Keybored02/simple_stepper_motor_analyzer_5A/3d/README.md

This model is designed to be output on an SLA printer.
The top and bottom of the case are just plugged into each other.
