Keybored02/simple_stepper_motor_analyzer_5A/3d/case_top.stl

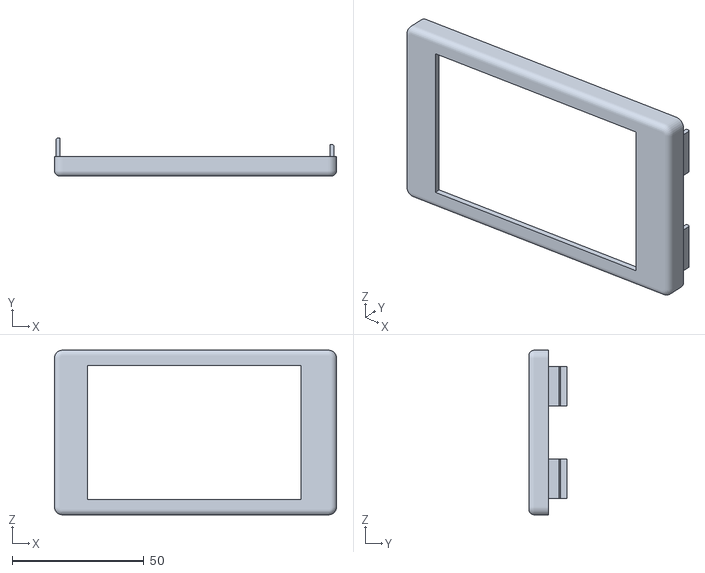
[picture p1: CAD file, 2022-09-28]
3d/case_top.stl
107.0 x 14.5 x 62.5
