Keybored02/simple_stepper_motor_analyzer_5A/3d/case_bottom.stl

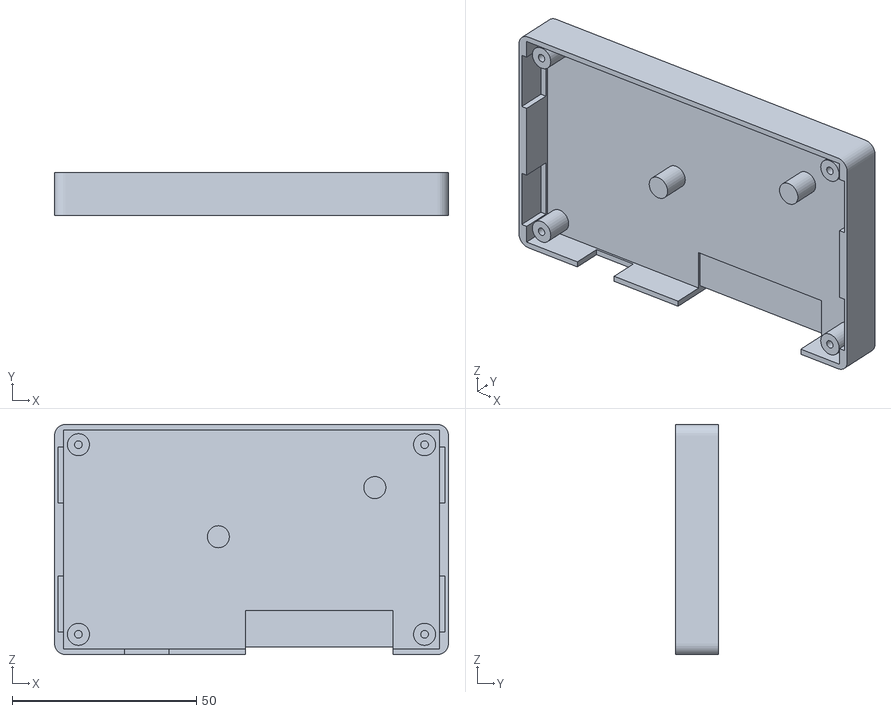
[picture p2: CAD file, 2022-09-06]
3d/case_bottom.stl
107.0 x 11.6 x 62.5
