Keybored02/simple_stepper_motor_analyzer_5A/platformio/src/ui/current_histogram_screen.cpp

#include "current_histogram_screen.h"

#include "acquisition/analyzer.h"
#include "misc/hardware_config.h"
#include "ui.h"

static constexpr uint32_t kUpdateIntervalMillis = 200;

static const ui::ChartAxisConfig kXAxisConfig_2500ma = {
    .range = {.min = 0, .max = 2000},  // ignored
    .labels = "0\n500\n1000\n1500\n2000",
    .num_ticks = 5,
    .dividers = 3};

static const ui::ChartAxisConfig kYAxisConfig_2500ma = {
    .range = {.min = 0, .max = 2500},
    .labels = "2.5A\n2.0\n1.5\n1.0\n0.5\n0.0",
    .num_ticks = 6,
    .dividers = 4};

static const ui::ChartAxisConfig kYAxisConfig_5000ma = {
    .range = {.min = 0, .max = 5000},
    .labels = "5A\n4\n3\n2\n1\n0",
    .num_ticks = 6,
    .dividers = 4};

CurrentHistogramScreen::CurrentHistogramScreen(){};

void CurrentHistogramScreen::setup(uint8_t screen_num) {
  ui::create_screen(&screen_);
  ui::create_page_elements(screen_, "CURRENT BY STEPS/SEC", screen_num,
                           nullptr);
  const uint16_t sensor_max_milliamps =
      hardware_config::sensor_spec()->range_milliamps;
  const ui::ChartAxisConfig* y_axis_config = (sensor_max_milliamps > 2500)
                                                 ? &kYAxisConfig_5000ma
                                                 : &kYAxisConfig_2500ma;
  ui::create_histogram(screen_, analyzer::kNumHistogramBuckets,
                       kXAxisConfig_2500ma, *y_axis_config, &histogram_);
  ui::create_label(screen_, 300,60, 290, "", ui::kFontDataFields, LV_LABEL_ALIGN_LEFT, LV_COLOR_SILVER, &average_current_label_);
};

void CurrentHistogramScreen::on_load() {
  // Force display update on first loop.
  display_update_elapsed_.set(kUpdateIntervalMillis + 1);
};

void CurrentHistogramScreen::on_unload(){};

void CurrentHistogramScreen::on_event(ui_events::UiEventId ui_event_id) {
  switch (ui_event_id) {
    case ui_events::UI_EVENT_RESET:
      analyzer::reset_state();
      break;
    default:
      break;
  }
}

void CurrentHistogramScreen::loop() {
  // We update at a fixed rate.
  uint32_t avg_total = 0, peak = 0;
  uint8_t qty = 0;
  if (display_update_elapsed_.elapsed_millis() < kUpdateIntervalMillis) {
    return;
  }
  display_update_elapsed_.reset();

  // Sample acquisition state and update display.
  const analyzer::State* state = analyzer::sample_state();

  // Update all the histogram points.
  const hardware_config::SensorSpec* sensor_spec =
      hardware_config::sensor_spec();
  for (int i = 0; i < analyzer::kNumHistogramBuckets; i++) {
    uint64_t total_current_ticks = state->buckets[i].total_step_peak_currents;
    uint64_t steps = state->buckets[i].total_steps;
    uint16_t avg_peak_milliamps =
        steps > 0
            ? sensor_spec->adc_value_to_milliamps(total_current_ticks / steps)
            : 0;

    histogram_.lv_series->points[i] = avg_peak_milliamps;
    if( steps > 0 ) {
      avg_total += avg_peak_milliamps;
      peak = avg_peak_milliamps > peak ? avg_peak_milliamps : peak;
      qty++;
    }
  }
  lv_chart_refresh(histogram_.lv_chart);
    //average_current_label_.set_text_float(qty == 0 ? 0 : avg_total / qty, 0);
  if( qty > 0){   
    lv_label_set_text_fmt(average_current_label_.lv_label, "Avg:%4.2d  Peak:%4.2d", avg_total / qty, peak );
  }
  else{
    average_current_label_.set_text("Waiting...");
  }
}
