Keybored02/simple_stepper_motor_analyzer_5A/(commit log)

2022-06-30 Add avg and peak values to current histogram page
2022-09-06 add 3d case model
    [case_bottom.stl, case_top.stl, connector_trim_jig.stl, enclosure_metal_insert_threads.stl, enclosure_self_tapping_threads.stl]
2022-09-06 update to current kicad model (for CC6920BSO)
    [stepper_analyzer.kicad_pcb, stepper_analyzer.sch]
2022-09-28 fix dimensions of case top model
    [case_top.stl]
